electronicexpert/BLDC_Work/Hardware/pictures/AMAZON_BLDC_HALL.jpg

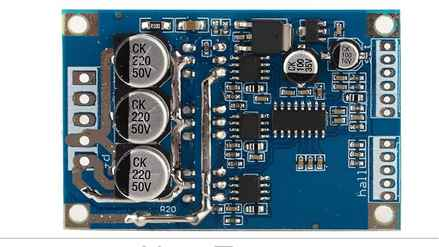
Hardware/pictures/AMAZON_BLDC_HALL.jpg
