electronicexpert/BLDC_Work/Hardware/pictures/First_PCP_of_mine.jpg

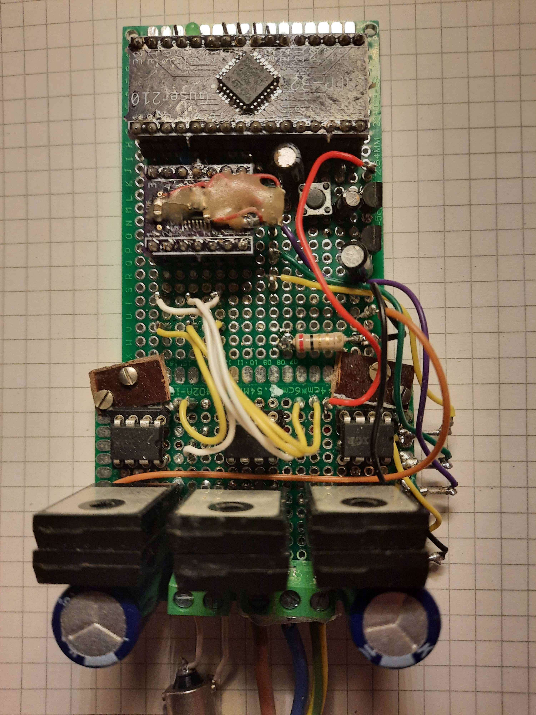
Hardware/pictures/First_PCP_of_mine.jpg
