electronicexpert/BLDC_Work/README.md

# BLDC_Work
some experiments with BLDC Motors and drivers

Thanks to Gil Vargas for the inspiration. I tried out some motors and controllers. In the end I build one myself, very close to Gil's draft.
