electronicexpert/BLDC_Work/Hardware/pictures/AMAZON_BLDC_BEMF.jpg

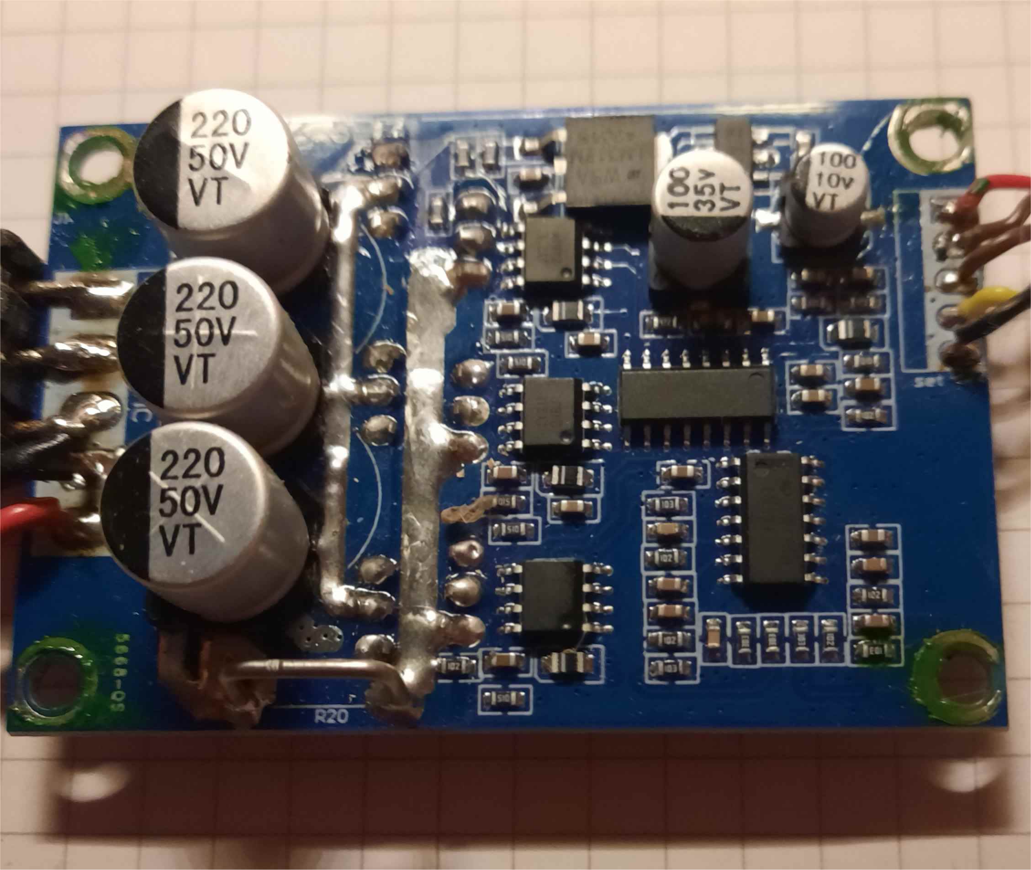
Hardware/pictures/AMAZON_BLDC_BEMF.jpg
