electronicexpert/BLDC_Work/Hardware/pictures/AMAZON_BLDC_Motor.jpg

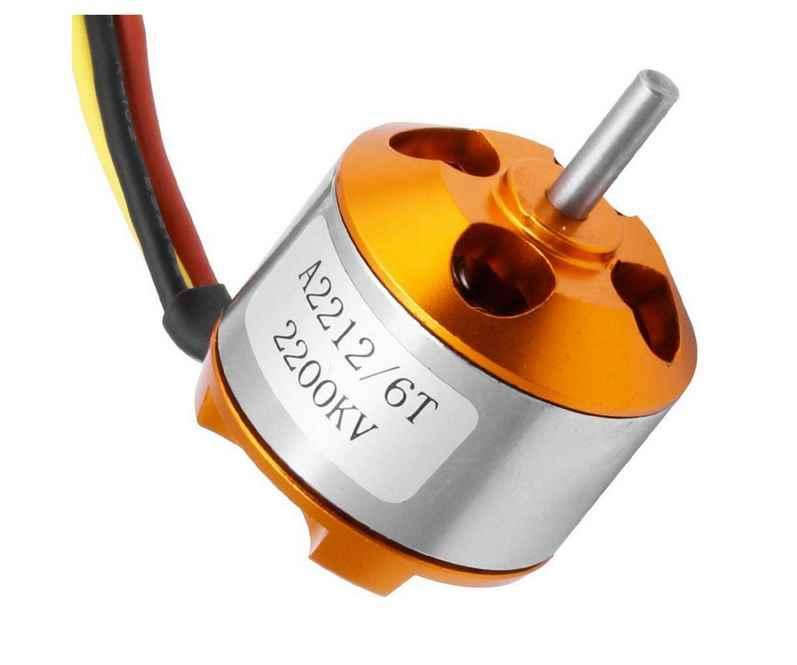
Hardware/pictures/AMAZON_BLDC_Motor.jpg
