electronicexpert/BLDC_Work/Hardware/Eagle/BLDC_Motor_Controller_ADP3120A.brd

## EAGLE design Hardware/Eagle/BLDC_Motor_Controller_ADP3120A.brd (2024-08-16)

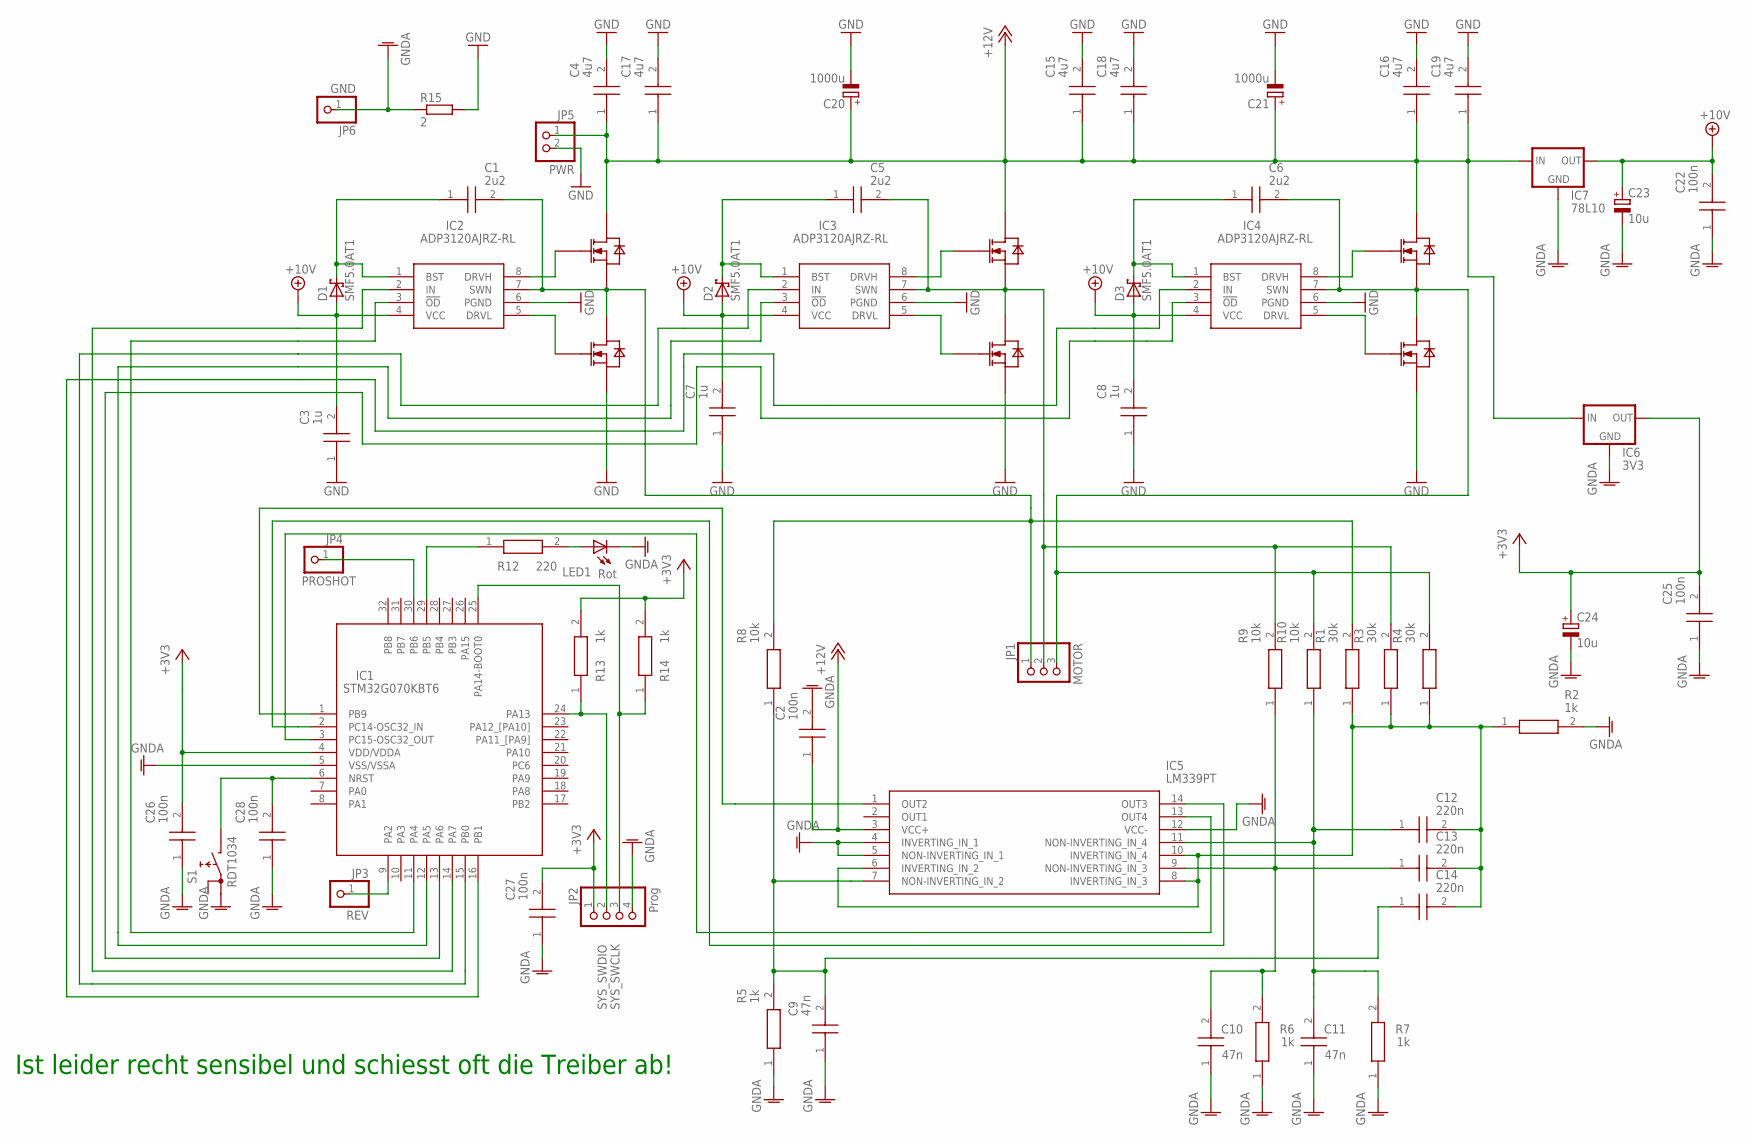
[picture p6: schematic BLDC_Motor_Controller_ADP3120A.sch]

Parts:
C1, C5, C6: 2u2; CAPC2012X135N
C2, C22, C25, C26, C27, C28: 100n; CAPC2012X145N
C3, C7, C8: 1u; GRM31X
C4, C15, C16, C17, C18, C19: 4u7; GRM31X
C9, C10, C11: 47n; CAPC2012X145N
C12, C13, C14: 220n; CAPC2012X145N
C20, C21: 1000u; 150CLZ-0810
C23, C24: 10u; SMC_C
D1, D2, D3: SMF5.0AT1; SOD123FL
IC1: STM32G070KBT6; QFP80P900X900X160-32N
IC2, IC3, IC4: ADP3120AJRZ-RL; SOIC127P600X175-8N
IC5: LM339PT; SOP65P640X120-14N
IC6: 3V3; SOT89R
IC7: 78L10; SOT89R
JP1: MOTOR; 1X03
JP2: Prog; 1X04
JP3: REV; 1X01
JP4: PROSHOT; 1X01
JP5: PWR; 1X02
JP6: GND; 1X01
LED1: Rot; SML0805
Q1, Q2, Q3, Q4, Q5, Q6: IRFR1205TRPBF; TO229P991X239-3_4N
R1, R3, R4: 30k; ERJUP6
R2, R5, R6, R7, R13, R14: 1k; ERJUP6
R8, R9, R10: 10k; ERJUP6
R12: 220; ERJUP6
R15: 2; R2012
S1: RDT1034

Connections:
+3V3: C24.+, C25.2, C26.2, C27.2, IC1.4 (VDD/VDDA), IC6.3 (OUT), JP2.1, R13.2, R14.2
+10V: C3.2, C7.2, C8.2, C22.2, C23.+, D1.A, D2.A, D3.A, IC2.4 (VCC), IC3.4 (VCC), IC4.4 (VCC), IC7.3 (OUT)
+12V: C2.1, C4.1, C15.1, C16.1, C17.1, C18.1, C19.1, C20.+, C21.+, IC5.3 (VCC+), IC6.2 (IN), IC7.2 (IN), JP5.1, Q1.4 (DRAIN), Q3.4 (DRAIN), Q5.4 (DRAIN)
BEMF_U: C9.2, C14.1, IC5.7 (NON-INVERTING_IN_2), R5.2, R8.1
BEMV_GND: C12.2, C13.2, C14.2, IC5.6 (INVERTING_IN_2), IC5.8 (INVERTING_IN_3), IC5.10 (INVERTING_IN_4), R1.1, R2.1, R3.1, R4.1
BEMV_V: C10.2, C13.1, IC5.9 (NON-INVERTING_IN_3), R6.2, R9.1
BEMV_W: C11.2, C12.1, IC5.11 (NON-INVERTING_IN_4), R7.2, R10.1
GND: C3.1, C4.2, C7.1, C8.1, C15.2, C16.2, C17.2, C18.2, C19.2, C20.-, C21.-, IC2.6 (PGND), IC3.6 (PGND), IC4.6 (PGND), JP5.2, Q2.3 (SOURCE), Q4.3 (SOURCE), Q6.3 (SOURCE), R15.2
GNDA: C2.2, C9.1, C10.1, C11.1, C22.1, C23.-, C24.-, C25.1, C26.1, C27.1, C28.1, IC1.5 (VSS/VSSA), IC5.4 (INVERTING_IN_1), IC5.5 (NON-INVERTING_IN_1), IC5.12 (VCC-), IC6.1 (GND), IC7.1 (GND), JP2.4, JP6.1, LED1.C, R2.2, R5.1, R6.1, R7.1, R15.1, S1.A1
IN_U: IC1.14 (PA7), IC2.2 (IN)
IN_V: IC1.15 (PB0), IC3.2 (IN)
IN_W: IC1.16 (PB1), IC4.2 (IN)
unnamed: LED1.A, R12.2
unnamed: IC3.8 (DRVH), Q3.1 (GATE)
unnamed: IC3.5 (DRVL), Q4.1 (GATE)
unnamed: IC2.8 (DRVH), Q1.1 (GATE)
unnamed: IC2.5 (DRVL), Q2.1 (GATE)
unnamed: IC4.8 (DRVH), Q5.1 (GATE)
unnamed: IC4.5 (DRVL), Q6.1 (GATE)
unnamed: C1.1, D1.C, IC2.1 (BST)
unnamed: IC1.29 (PB5), R12.1
unnamed: C5.1, D2.C, IC3.1 (BST)
unnamed: IC1.9 (PA2), JP3.1
unnamed: C6.1, D3.C, IC4.1 (BST)
unnamed: IC1.2 (PC14-OSC32_IN), IC5.14 (OUT3)
unnamed: C28.2, IC1.6 (NRST), S1.B
unnamed: IC1.1 (PB9), IC5.1 (OUT2)
unnamed: IC1.3 (PC15-OSC32_OUT), IC5.13 (OUT4)
unnamed: IC1.30 (PB6), JP4.1
OD_U: IC1.11 (PA4), IC2.3 (!OD)
OD_V: IC1.12 (PA5), IC3.3 (!OD)
OD_W: IC1.13 (PA6), IC4.3 (!OD)
SYS_SWCLK: IC1.25 (PA14-BOOT0), JP2.3, R14.1
SYS_SWDIO: IC1.24 (PA13), JP2.2, R13.1
U: C1.2, IC2.7 (SWN), JP1.1, Q1.3 (SOURCE), Q2.4 (DRAIN), R1.2, R8.2
V: C5.2, IC3.7 (SWN), JP1.2, Q3.3 (SOURCE), Q4.4 (DRAIN), R3.2, R9.2
W: C6.2, IC4.7 (SWN), JP1.3, Q5.3 (SOURCE), Q6.4 (DRAIN), R4.2, R10.2

Notes on the sheet:
Ist leider recht sensibel und schiesst oft die Treiber ab!

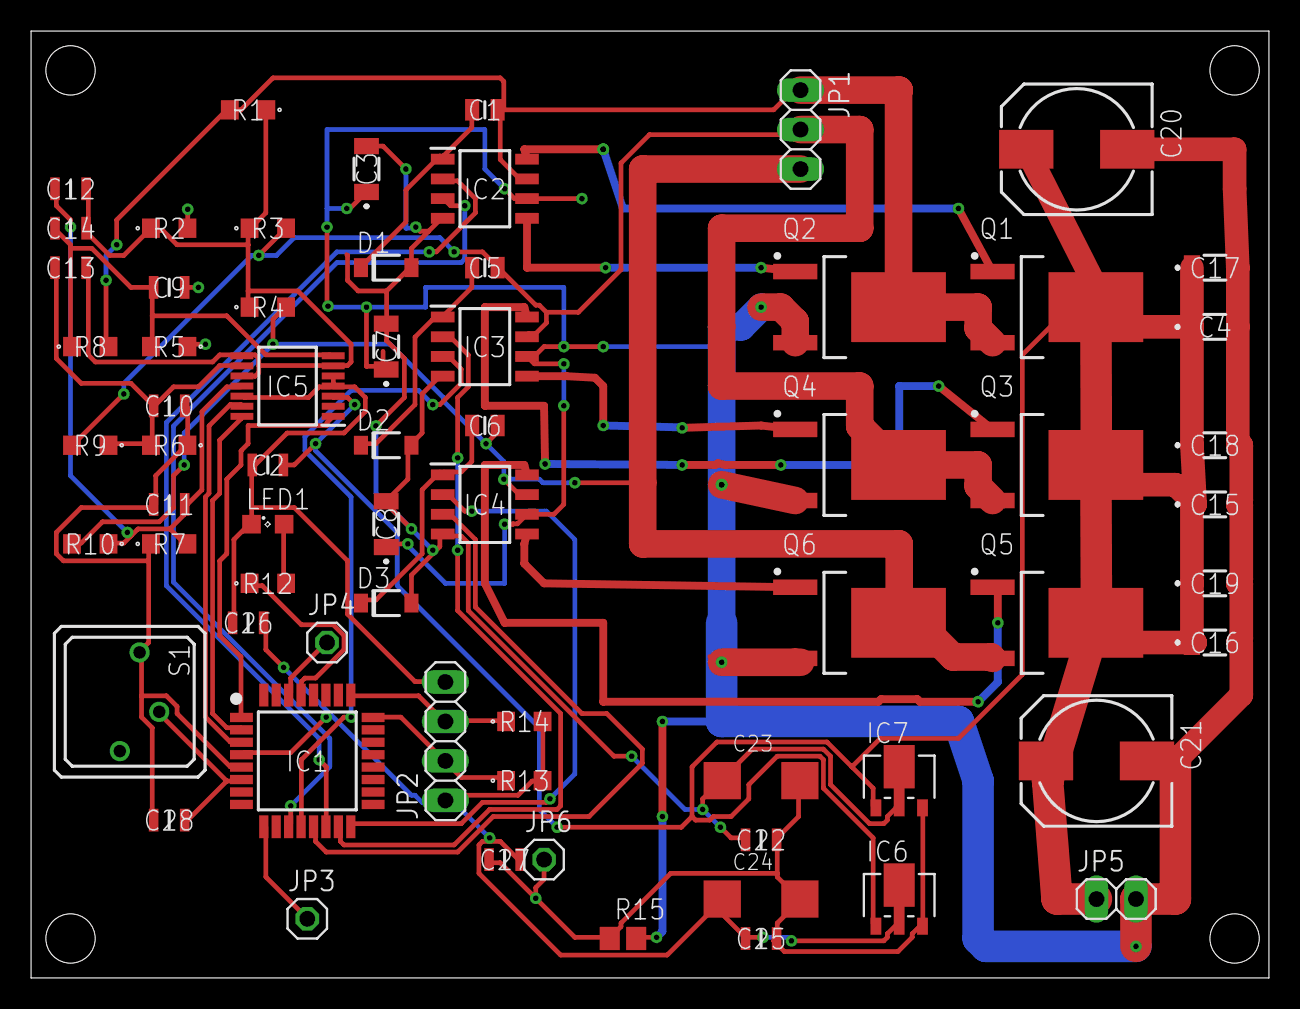
[picture p7: board BLDC_Motor_Controller_ADP3120A.brd from above]

Board: 2 copper layers, 79.7 x 61.0 mm, 66 parts (0 on the bottom side), 37 nets.
