electronicexpert/BLDC_Work/Software/BLDC_MOTOR_5_SRC/BLDC_MOTOR_5.ioc

Mcu.UserName=STM32G070KBTx
PA13.Signal=SYS_SWDIO
PA14-BOOT0.Signal=SYS_SWCLK
PA2.GPIO_Label=REV
PA2.Signal=GPIO_Input
PA4.GPIO_Label=OD_A
PA4.Signal=GPIO_Output
PA5.GPIO_Label=OD_B
PA5.Signal=GPIO_Output
PA6.GPIO_Label=OD_C
PA6.Signal=GPIO_Output
PA7.GPIO_Label=PWM_A
PA7.Signal=S_TIM3_CH2
PB0.GPIO_Label=PWM_B
PB0.Signal=S_TIM3_CH3
PB1.GPIO_Label=PWM_C
PB1.Signal=S_TIM3_CH4
PB5.GPIO_Label=LED
PB5.Signal=GPIO_Output
PB6.GPIO_Label=Proshot
PB6.Signal=S_TIM1_CH3
PB9.GPIO_Label=ZC_A
PB9.Signal=GPXTI9
