electronicexpert/BLDC_Work/Software/BLDC_MOTOR_5_SRC/Core/Inc/main.h

#define ZC_A_Pin GPIO_PIN_9
#define ZC_A_GPIO_Port GPIOB
#define ZC_A_EXTI_IRQn EXTI4_15_IRQn
#define ZC_B_Pin GPIO_PIN_14
#define ZC_B_GPIO_Port GPIOC
#define ZC_B_EXTI_IRQn EXTI4_15_IRQn
#define ZC_C_Pin GPIO_PIN_15
#define ZC_C_GPIO_Port GPIOC
#define ZC_C_EXTI_IRQn EXTI4_15_IRQn
#define REV_Pin GPIO_PIN_2
#define REV_GPIO_Port GPIOA
#define OD_A_Pin GPIO_PIN_4
#define OD_A_GPIO_Port GPIOA
#define OD_B_Pin GPIO_PIN_5
#define OD_B_GPIO_Port GPIOA
#define OD_C_Pin GPIO_PIN_6
#define OD_C_GPIO_Port GPIOA
#define PWM_A_Pin GPIO_PIN_7
#define PWM_A_GPIO_Port GPIOA
#define PWM_B_Pin GPIO_PIN_0
#define PWM_B_GPIO_Port GPIOB
#define PWM_C_Pin GPIO_PIN_1
#define PWM_C_GPIO_Port GPIOB
#define LED_Pin GPIO_PIN_5
#define LED_GPIO_Port GPIOB
#define Proshot_Pin GPIO_PIN_6
#define Proshot_GPIO_Port GPIOB
