electronicexpert/BLDC_Work/Software/BLDC_Proshot_Controller_for_4_Motors/Core/Src/main.c

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
/* Includes ------------------------------------------------------------------*/
#include "main.h"

CRC_HandleTypeDef hcrc;

UART_HandleTypeDef huart5;

void SystemClock_Config(void);
static void MX_GPIO_Init(void);
static void MX_UART5_Init(void);
static void MX_CRC_Init(void);
/* USER CODE BEGIN 0 */

uint8_t test = 0;
uint8_t ready = 0;
uint8_t Rx_data[1];



const struct Impuls imp = {.Impuls_Delta=22,.Impuls_Base=181,.Impuls_Distance=732};

struct Motor m1;
struct Motor m2;
struct Motor m3;
struct Motor m4;

volatile GPIO_PinState Pintable[8] = {GPIO_PIN_RESET,GPIO_PIN_SET,GPIO_PIN_RESET,GPIO_PIN_SET,GPIO_PIN_RESET,GPIO_PIN_SET,GPIO_PIN_RESET,GPIO_PIN_SET};
volatile uint32_t Pulsetable_M1[8] = {0,0,0,0,0,0,0,0};
volatile uint32_t Pulsetable_M2[8] = {0,0,0,0,0,0,0,0};
volatile uint32_t Pulsetable_M3[8] = {0,0,0,0,0,0,0,0};
volatile uint32_t Pulsetable_M4[8] = {0,0,0,0,0,0,0,0};


volatile unsigned char OC_CH1_N = 0;
volatile unsigned char OC_CH2_N = 0;
volatile unsigned char OC_CH3_N = 0;
volatile unsigned char OC_CH4_N = 0;





/* USER CODE END 0 */

/**
  * @brief  The application entry point.
  * @retval int
  */
int main(void)
{

  /* MCU Configuration--------------------------------------------------------*/

  /* Reset of all peripherals, Initializes the Flash interface and the Systick. */
  HAL_Init();

  /* Configure the system clock */
  SystemClock_Config();

  /* Initialize all configured peripherals */
  MX_GPIO_Init();
  MX_UART5_Init();
  MX_CRC_Init();
  /* Infinite loop */
  /* USER CODE BEGIN WHILE */


  // Timer 1 pre-settings:

   RCC->APB2ENR = RCC_APB2ENR_TIM1EN; // enable timer 1 in RCC
   TIM1->PSC = 0; //
   TIM1->EGR = TIM_EGR_UG; // update event to write prescaler shadow register
   TIM1->SR = 0; // clear interrupt flag set by the update event
   TIM1->ARR = 11584 - 1; // must be > CCR1 (fuer 64us)
   TIM1->CCR1 = 100 - 1;  // initial OC for motor1
   TIM1->CCR2 = 3010 - 1; // initial OC for motor2
   TIM1->CCR3 = 5820 - 1; // initial OC for motor3
   TIM1->CCR4 = 8630 - 1; // initial OC for motor4
   TIM1->DIER = TIM_DIER_UIE | TIM_DIER_CC4IE | TIM_DIER_CC3IE | TIM_DIER_CC2IE | TIM_DIER_CC1IE; // enable all CC and update interrupts
   NVIC_EnableIRQ(TIM1_CC_IRQn); // enable CC interrupt in NVIC
   NVIC_EnableIRQ(TIM1_UP_TIM10_IRQn); // enable update interrupt in NVIC

   // Timer will be started in  main.cpp


  maincpp();


  while (1)
  {
    /* USER CODE END WHILE */

    /* USER CODE BEGIN 3 */
  }
  /* USER CODE END 3 */
}

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
/* USER CODE BEGIN 4 */
void HAL_UART_RxCpltCallback(UART_HandleTypeDef *huart)
{
	test = Rx_data[0];
	ready = 1;
	HAL_UART_Receive_IT (&huart5, Rx_data, 1);

}

void TIM1_UP_TIM10_IRQHandler(void)
{
	TIM1->SR = 0; // clear interrupt flags before proceeding
}


// interrupt handler for TIM1 capture/compare event

void TIM1_CC_IRQHandler(void)
{
	uint32_t sr = TIM1->SR; // read interrupt flags
   	TIM1->SR = 0; // clear interrupt flags before proceeding
   	if(sr & TIM_SR_CC1IF)    // Motor 1 will be serviced , CC1 triggered
   	{
   	   HAL_GPIO_WritePin(Proshot1_GPIO_Port,Proshot1_Pin,Pintable[OC_CH1_N]);
	   TIM1->CCR1 = Pulsetable_M1[OC_CH1_N];
	   OC_CH1_N++;
	   if(OC_CH1_N == 8)
	   {
		   OC_CH1_N = 0;
	   }
   	}
	if(sr & TIM_SR_CC2IF)    // Motor 2 will be serviced , CC2 triggered
   	{
	   HAL_GPIO_WritePin(Proshot2_GPIO_Port,Proshot2_Pin,Pintable[OC_CH2_N]);
	   TIM1->CCR2 = Pulsetable_M2[OC_CH2_N];
	   OC_CH2_N++;
	   if(OC_CH2_N == 8)
	   {
		   OC_CH2_N = 0;
	   }
   	}

	if(sr & TIM_SR_CC3IF)    // Motor 3 will be serviced , CC3 triggered
	{
       HAL_GPIO_WritePin(Proshot3_GPIO_Port,Proshot3_Pin,Pintable[OC_CH3_N]);
	   TIM1->CCR3 = Pulsetable_M3[OC_CH3_N];
	   OC_CH3_N++;
	   if(OC_CH3_N == 8)
	   {
		   OC_CH3_N = 0;
	   }
	}

	if(sr & TIM_SR_CC4IF)    // Motor 4 will be serviced , CC4 triggered
	{
		HAL_GPIO_WritePin(Proshot4_GPIO_Port,Proshot4_Pin,Pintable[OC_CH4_N]);
		TIM1->CCR4 = Pulsetable_M4[OC_CH4_N];
		OC_CH4_N++;
		if(OC_CH4_N == 8)
		{
		  OC_CH4_N = 0;
	    }
	}

}



/* USER CODE END 4 */
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
