electronicexpert/BLDC_Work/(notices)

Notices in the files:
Software/BLDC_Proshot_Controller_for_4_Motors/Core/Src/main.c:
Copyright (c) 2024 STMicroelectronics.
All rights reserved.
This software is licensed under terms that can be found in the LICENSE file
