electronicexpert/BLDC_Work/Hardware/pictures/myBoard.jpg

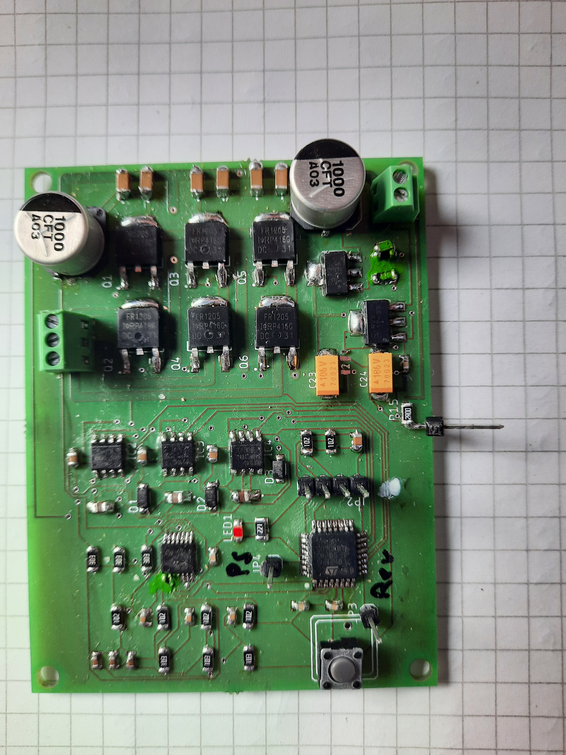
Hardware/pictures/myBoard.jpg
